grantmd/doorking-esp32/(commit log)

2026-04-11 Scaffold minimal ESP-IDF project for XIAO ESP32-C3
    First commit establishes a buildable ESP-IDF project targeting the Seeed
    XIAO ESP32-C3: top-level CMakeLists, sdkconfig.defaults (4 MB flash,
    two-OTA partition table, USB Serial/JTAG console, 1 kHz FreeRTOS tick),
    and a main component that logs chip info and heartbeats once per second.
    Confirmed building and flashing cleanly — this is our known-good starting
    point before adding gate state machine, NVS config, WiFi, and the HTTP
    API in subsequent commits.
2026-04-11 Add pure-C gate state machine with host-side tests
    gate_sm.{c,h} is a zero-dependency state machine that owns every gate
    transition rule: UNKNOWN → CLOSED/OPEN at boot, ACCEPTED/IDEMPOTENT/
    THROTTLED command results, OPENING→OPEN on status edge, OPENING→STOPPED
    on travel timeout, CLOSING→CLOSED on travel timeout (we have no closed
    sensor), CLOSING→OPEN when the DKS safety reverse re-asserts fully-open
    mid-close, and OPEN→CLOSING on an externally-triggered close (wired
    keypad, remote). Only the fully-open bit from the 4602-010 dry relay is
    available as ground truth; everything else is disambiguated via command
    history and a travel timer.
    test/test_gate_sm.c exercises 19 scenarios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
    [gate_sm.c, gate_sm.h, main.c]
2026-04-11 Add NVS config module with defaults-on-missing
    config.{c,h} wraps NVS access for the bridge's persistent settings: WiFi
    station credentials, HTTP bearer token, gate timings (pulse width, command
    throttle, travel timeout), and the mDNS hostname. config_load fills in
    compile-time defaults for any missing key so a blank device boots with
    sensible behaviour, and config_save writes the whole struct atomically in
    a single nvs_commit. Secrets (wifi_psk, auth_token) never appear in logs
    — config_log only reports whether they are set.
    main.c now initialises nvs_flash (erasing and retrying on
    NVS_NO_FREE_PAGES / NVS_NEW_VERSION_FOUND per the standard ESP-IDF
    pattern), loads config, logs it, and fee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
    [config.c, config.h, main.c]
2026-04-11 Add WiFi STA with AP-mode provisioning fallback
    wifi.{c,h} owns all WiFi bring-up and picks a mode at boot from the
    persisted config. If wifi_ssid is set we come up in STA mode with
    auto-reconnect on every WIFI_EVENT_STA_DISCONNECTED and modem power
    save disabled (latency over battery life for a wall-powered gate
    controller). Otherwise we come up in AP mode broadcasting an open
    "doorking-setup" SSID and start a tiny esp_http_server on port 80.
    The provisioning server serves two routes:
    GET / -> a ~1 KB HTML form with mobile-first CSS
    POST /provision -> parses application/x-www-form-urlencoded, writes
    ssid/psk to NVS, mints a fresh 64-hex-char bearer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
2026-04-11 Add README with status, build, and provisioning walkthrough
    Captures the current state of the project (scaffold + gate state machine
    + config + wifi provisioning done, HTTP API and hardware layer pending),
    documents the ESP-IDF toolchain install, covers build and flash from a
    fresh clone, and walks through the AP-mode provisioning flow end to end
    including the one-shot bearer token that only appears on the success
    page. Intended as a recoverable entry point for working on this repo
    after a break.
2026-04-11 Add factory reset via BOOT-button hold
    Press and hold the XIAO ESP32-C3 BOOT button (GPIO9) for 5 seconds
    while the firmware is running to clear wifi_ssid, wifi_psk, and
    auth_token from NVS and reboot into AP provisioning mode. Gate timings
    and hostname are preserved so the user only has to redo wifi.
    reset_btn_sm.{c,h} is a pure-C debounce + one-shot hold-threshold state
    machine with no ESP-IDF dependencies; 7 host-side tests in
    test/test_reset_btn_sm.c cover unpressed, under-threshold, at-threshold
    (fires exactly once), past-threshold single-sample fire, short-press
    re-arm, release-after-fire re-arm, and rapid press trains. The sm is
    consumed by a 50 ms polling FreeRTOS task in reset_butt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
    [config.c, config.h, main.c, reset_btn_sm.c, reset_btn_sm.h, reset_button.c, reset_button.h]
2026-04-11 Log bearer token to serial as a backup delivery channel
    When provisioning runs, the success HTML page is the primary channel
    for handing the user the newly-minted bearer token — but in practice
    iOS captive-portal views fail to render the page cleanly when the
    underlying AP is about to go away, so the user submits the form,
    sees a browser error, and the token is lost.
    Two backups:
    1. config_log now prints the full auth_token value at every boot.
    Threat-model comment inline: seeing it requires physical USB
    access, which is the same trust level as physical access to the
    gate controller itself. Tighten if needed later.
    2. handle_provision emits a WARN-level log with the freshly-min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
    [config.c, wifi.c]
2026-04-11 Stop httpd cleanly before provisioning reboot
    After submitting the provisioning form, the reboot task was yanking
    WiFi out from under any lingering httpd sockets (browser keepalives,
    favicon probes) during shutdown. Those sockets then hit EHOSTUNREACH
    on their next recv() and emit "httpd_sock_err: error in recv : 113"
    warnings. Harmless but noisy.
    Call httpd_stop before esp_restart so the provisioning server closes
    its listen socket and drains client sockets gracefully first. Also
    clear s_provision_httpd to NULL so the pointer is never dangling.
    [wifi.c]
2026-04-11 Add GitHub Actions workflow: host tests + firmware build + release on tag
    build.yml runs on every push to main, every PR to main, and every tag
    push matching v*. Always: run the host-side unit tests in test/, then
    invoke espressif/esp-idf-ci-action to build the ESP-IDF project for
    esp32c3 inside the official IDF v5.3 Docker image, and merge the
    partition binaries into a single doorking-merged.bin that can be
    flashed to 0x0 in one shot. All artifacts (individual partitions,
    merged image, elf) are uploaded as a workflow artifact for easy pickup
    from any run.
    On tag push (v*), additionally publish a GitHub Release via
    softprops/action-gh-release with the five binaries attached and
    auto-generat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
2026-04-11 Bump GitHub Actions to current majors
    actions/checkout v4 → v6 and actions/upload-artifact v4 → v7. v4 of
    both runs on node20 which is generating deprecation warnings on GH's
    hosted runners; the newer majors run on node24 and clear the warnings.
    Using floating major tags so future non-breaking patch releases land
    automatically. softprops/action-gh-release and
    espressif/esp-idf-ci-action are already on their current majors.
2026-04-11 Bump ESP-IDF to v5.5 in CI
    Verified locally that the entire existing firmware (gate_sm, config,
    wifi, reset_button, provisioning httpd, all 1008 build steps) builds
    clean on ESP-IDF v5.5.4-299 for esp32c3 with zero code changes, zero
    deprecation warnings, and zero API churn. Binary grows from 0xc9320
    bytes (v5.3) to 0xcd070 bytes (v5.5) — a ~16 KB increase from updated
    component libraries, still leaving 20% free in the 1 MB app partition.
    v5.5 is the first ESP-IDF release with stable ESP32-C5 support, which
    unblocks the upcoming multi-target refactor. The workflow pin moves
    from v5.3 to v5.5; other actions stay as-is.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
2026-04-11 Refactor to multi-target layout: split sdkconfig.defaults + board.h
    Pure refactor, no behavior change on esp32c3. Introduces the scaffolding
    required to add esp32 (SparkFun Thing Plus WROOM) and esp32c5 (SparkFun
    Thing Plus C5) targets in subsequent commits.
    sdkconfig.defaults now holds only settings shared across every
    supported target: the two-OTA partition layout, the 1 kHz FreeRTOS
    tick, the compiler warning flags, and the esp_http_server header/URI
    buffer sizes. CONFIG_IDF_TARGET is no longer pinned there; it is now
    chosen at configure time by idf.py set-target, and ESP-IDF merges the
    matching sdkconfig.defaults.<target> automatically on top of the
    common defaults.
    sdkconfig.defaults.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
    [board.h, main.c, reset_button.c]
2026-04-11 Rewrite README for multi-target framing
    Drops the C3-only assumptions that survived from the initial scaffold
    and reframes the project as a multi-target firmware that happens to be
    verified on C3 today. New "Supported targets" table lists the C3 as
    done, WROOM and C5 as planned. Hardware section standardises on the
    Qwiic / I2C Single Relay topology across all three targets (two
    SparkFun Qwiic Single Relays at 0x18 and 0x19, daisy-chained) instead
    of the previous HW-383 GPIO relay module.
    Wiring-to-DKS table now expresses signals in target-independent terms
    (relay I2C address + pin numbers) rather than in terms of specific
    ESP32-C3 GPIOs, so the same table works for every supported board.
    I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
2026-04-11 Add esp32 (SparkFun Thing Plus WROOM) target
    sdkconfig.defaults.esp32 pins the 16 MB flash size, notes that the
    common CONFIG_PARTITION_TABLE_TWO_OTA layout only uses the first ~3 MB
    (we can revisit if the binary ever grows past 1 MB), and documents why
    no console routing override is needed (UART0 is the ESP32 default and
    the board's onboard CH340C USB-UART bridge exposes it over USB-C).
    main/board.h gains a #elif CONFIG_IDF_TARGET_ESP32 block defining
    BOARD_NAME and RESET_BUTTON_GPIO=0 for the Thing Plus. GPIO0 is the
    BOOT button on every ESP32 Feather/Thing Plus and, like GPIO9 on the
    C3, is a strapping pin — so the runtime-press-only caveat still
    applies.
    GOTCHA specific to this board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
2026-04-11 CI: matrix-build esp32c3 + esp32, split release into its own job
    Convert the single-target build job into a strategy.matrix.include with
    per-target flash_size, flash_freq, and bootloader_offset. The XIAO
    ESP32-C3 uses a 4 MB / 80 MHz / 0x0-bootloader layout; the SparkFun
    Thing Plus WROOM uses 16 MB / 40 MHz / 0x1000-bootloader. fail-fast is
    off so one target breaking doesn't hide the state of the other.
    Artifacts upload per-target as firmware-<target> (each matrix cell runs
    upload-artifact independently). The merged binary produced by esptool
    merge_bin is now renamed to doorking-<target>-merged.bin so both
    targets' outputs can coexist in a single release without filename
    collision.
    The rel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
2026-04-11 Add esp32c5 (SparkFun Thing Plus ESP32-C5) target
    Third supported target, joining esp32c3 (XIAO) and esp32 (Thing Plus
    WROOM). Adds sdkconfig.defaults.esp32c5 with the 8 MB flash size and
    the ESP32-C5's native USB Serial/JTAG console routing, a board.h
    block for the SparkFun Thing Plus C5 with BOARD_NAME and
    RESET_BUTTON_GPIO=28 (the C5's boot-mode strapping pin — different
    from C3's GPIO9 and ESP32's GPIO0), and a third CI matrix cell so
    every push builds the C5 binary alongside the other two.
    Pin for BOOT button confirmed from the SparkFun Thing Plus C5
    datasheet PDF (~/SparkFun_Thing_Plus_ESP32_C5.pdf via sparkfun.com
    CDN), not guessed from strapping-pin conventions. Worth noting becau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
2026-04-11 Switch default build to -Os and disable 802.15.4 on C5
    Flipping CONFIG_COMPILER_OPTIMIZATION_SIZE=y in the common
    sdkconfig.defaults moves every target from -Og (debuggable) to -Os
    (size-optimised), which saves a meaningful chunk of app-partition
    runway. Assertions stay on; debug symbols still fine for serial-log
    debugging; the only real cost is slightly harder step-through via
    JTAG, which we're not doing anyway.
    Also sets CONFIG_IEEE802154_ENABLED=n in sdkconfig.defaults.esp32c5
    so the Thread/Zigbee radio driver path is explicitly opted out on the
    C5. Savings are modest (~8 KB, most of the 802.15.4 code lives in a
    precompiled blob the linker can't strip) but the Kconfig setting
    records the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
2026-04-12 Add scripts/idf.sh wrapper for sandbox-friendly build invocations
    Running idf.py requires sourcing ESP-IDF's export.sh first, and the
    canonical ". ~/esp/esp-idf-v5.5/export.sh && idf.py build" pattern
    has the POSIX source operator as its first command token. That's an
    unbounded command prefix from a sandbox / agent whitelist standpoint
    — permitting it effectively permits sourcing anything on disk — so
    it's reasonable to refuse to whitelist. Without a whitelist, every
    build invocation from an agent hits manual approval, which kills the
    feedback loop on this multi-target project where we're running
    per-target builds all day.
    scripts/idf.sh is a thin wrapper that sources $HOME/esp/esp-idf-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
2026-04-12 Switch to TWO_OTA_LARGE partition layout + idf.py merge-bin in CI
    CONFIG_PARTITION_TABLE_TWO_OTA_LARGE replaces TWO_OTA in the common
    sdkconfig.defaults, growing the OTA app slots from 1 MB to 1700 KB
    each. There is no factory slot in this layout — OTA still works
    exactly the same way (ping-pongs between ota_0 and ota_1, supports
    rollback) because the factory slot is only relevant for commercial
    products where an unrecoverable brick is a business problem. For a
    developer-owned gate controller where USB re-flash is a 10-second
    operation, the factory slot is zero-value storage and swapping it
    for 1.4 MB of additional app headroom is a clean win.
    Verified locally on all three targets after a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
2026-04-12 README: update status, partition sizes, install paths, repo layout
    Align the README with the current reality of the repo:
    * Status table now records that esp32c3 and esp32 are both
    build-verified AND hardware-verified on real boards (XIAO
    ESP32-C3, SparkFun Thing Plus WROOM), while esp32c5 is
    build-verified only. Adds rows for the per-target board.h pin
    map (all three filled), size-optimised -Os build with
    TWO_OTA_LARGE 1700 KB slots, the scripts/idf.sh wrapper, and the
    3-target matrix CI.
    * Binary size table shows current figures under the new
    partition layout: esp32c3 744 KB / 56 % free, esp32 724 KB / 57 %
    free, esp32c5 825 KB / 51 % free. This replaces the older
    "only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
2026-04-12 Add RAM log ring buffer, HTTP API skeleton, GET /health and GET /logs
    Three new modules land in one commit because they're tightly coupled:
    log_buffer.{c,h}
    16 KB circular byte buffer protected by a FreeRTOS mutex. Installed
    via esp_log_set_vprintf FIRST in app_main — before NVS, WiFi, or
    any other module logs anything — so boot-time output is captured.
    The hook tees every formatted log line to both the ring buffer and
    stdout (via fputs) so the serial monitor continues to work when USB
    is attached. log_buffer_snapshot returns a malloc'd chronological
    copy of the current contents for consumption by the HTTP handler.
    http_api.{c,h}
    Main STA-mode HTTP server (separate from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
    [http_api.c, http_api.h, log_buffer.c, log_buffer.h, main.c]
2026-04-12 Add GET /status, POST /open, POST /close gate-control endpoints
    Three new bearer-authed endpoints in http_api.c, all wired to the
    same gate_sm instance that the tick loop drives:
    GET /status — returns {"state":"UNKNOWN","last_cmd":"none",
    "last_cmd_age_s":0} with the current gate state,
    the most recent accepted command, and seconds since
    that command was issued. Homebridge's HTTP garage-
    door plugin polls this to update HomeKit state.
    POST /open — calls gate_sm_on_cmd_open. Returns {"result":
    "accepted"} and transitions the state machine to
    OPENING, or {"result":"idempotent"} if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
    [gate_sm.c, gate_sm.h, http_api.c, http_api.h, main.c]
2026-04-12 Add mDNS so the device advertises as <hostname>.local
    In STA mode the firmware now calls mdns_init, sets the hostname from
    config (default "doorking"), and advertises an _http._tcp service on
    port 80. This lets the user (and Homebridge) reach the device at
    doorking.local without needing to discover its DHCP-assigned IP from
    the serial monitor or the router's client list.
    The mdns component was removed from the ESP-IDF source tree in v5.5
    and moved to the IDF Component Registry. main/idf_component.yml
    declares the dependency on espressif/mdns, which the component
    manager downloads into managed_components/ at build time (already
    gitignored).
    mDNS init is guarded by config_has_wifi so it only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
2026-04-12 Add I²C master bus init + boot-time device scan
    i2c_bus.{c,h} initialises the I²C master on the board-specific
    SDA/SCL pins (from board.h) at 100 kHz standard mode with internal
    pull-ups, then probes every 7-bit address from 0x01 to 0x77 and logs
    each responding device at INFO level. Known addresses are labelled
    inline:
    0x18 → SparkFun Qwiic Relay (default address)
    0x19 → SparkFun Qwiic Relay (alt address)
    0x36 → MAX17048 battery fuel gauge (onboard on the Thing Plus)
    The scan runs once at boot for diagnostics — "did the Qwiic cable
    come loose?" is a common field-debugging question — and returns the
    i2c_master_bus_handle_t for the future relay_i2c driver to register
    devic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
    [board.h, i2c_bus.c, i2c_bus.h, main.c]
2026-04-12 README: update status table and repo layout for latest modules
    Status table now reflects the HTTP API (/health, /logs, /status, /open,
    /close), the 16 KB RAM log ring buffer, mDNS, and the I²C bus init +
    boot-time device scan — all of which landed since the last README pass.
    Qwiic Relay I²C driver row clarifies that relay pulse stubs exist in
    the /open and /close handlers and are waiting on hardware. Binary sizes
    updated to current measurements including all new modules.
    Repo layout tree adds http_api, log_buffer, i2c_bus, and
    idf_component.yml (IDF Component Registry manifest for mdns).
2026-04-12 Add WS2812 status LED driven by WiFi state
    status_led.{c,h} maps high-level WiFi states to solid colours on the
    onboard WS2812 (NeoPixel) RGB LED:
    blue — AP provisioning mode, waiting for WiFi setup
    yellow — STA mode, connecting to WiFi
    green — STA mode, connected and ready
    red — STA mode, WiFi lost (auto-reconnecting)
    Brightness is capped at 24/255 so the LED is visible but not blinding
    inside a dark gate-operator enclosure.
    On the XIAO ESP32-C3 (no user-controllable LED), all status_led
    functions compile as empty no-ops — guarded by #ifdef STATUS_LED_GPIO
    in board.h. The WS2812 GPIO pin is board-specific:
    esp32 (Thing Plus WROOM): GPIO2
    esp32c5 (Thing Pl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
2026-04-12 Add OTA update support with push, pull, and dashboard
    Two update paths: push (POST /update with a binary) for development,
    and pull (periodic GitHub Releases check) for in-field updates. The
    device checks every 6 hours by default (configurable via NVS) and
    caches the available version for the dashboard and /health endpoint.
    Key pieces:
    - Version embedded via git describe → PROJECT_VER → esp_app_desc_t
    - Rollback protection: CONFIG_BOOTLOADER_APP_ROLLBACK_ENABLE with a
    120 s WiFi watchdog; bad firmware self-heals on next reboot
    - GET / serves a lightweight dashboard showing version, target, GitHub
    link, and an "Update firmware" button when an update is available
    - GET /health now ret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
    [config.c, config.h, http_api.c, http_api.h, main.c, ota.c, ota.h, status_led.c]
2026-04-13 Add POST /reboot endpoint for remote device restart
    Bearer-authenticated endpoint that sends a JSON response then restarts
    the device after a 1-second delay. Useful for triggering an OTA check
    cycle or general remote management without physical access.
    [http_api.c, http_api.h]
2026-04-13 Fix pull OTA: manually follow HTTP 302 redirects from GitHub CDN
    esp_http_client_open + manual read loop doesn't auto-follow redirects
    (that's only done by esp_http_client_perform, which buffers the entire
    response). GitHub's asset download URLs always 302 to their CDN, so
    the download was failing with "unexpected HTTP status 302".
    Fix: loop up to 5 times, reading the Location header on 3xx responses
    and re-opening the connection to the redirect target.
    [ota.c]
2026-04-13 Add dashboard check/reboot buttons, POST /update/check, update README
    Dashboard now has "Check for updates" (triggers a GitHub check, reloads
    after 5s) and "Reboot" buttons alongside the existing update button.
    All three prompt for the bearer token on first use and cache it for the
    session.
    New endpoint POST /update/check runs a check-only GitHub query (no
    install) and updates the cached available version.
    README updated to reflect OTA support, new endpoints, binary sizes,
    repo layout, and added an OTA section documenting both update paths,
    the dashboard, and rollback behaviour.
    [http_api.c, http_api.h, ota.c, ota.h]
2026-04-13 Fix pull OTA redirect: use esp_http_client_set_redirection
    esp_http_client_get_header looks up request headers, not response
    headers — so the Location header was never found. The client already
    parses Location internally; esp_http_client_set_redirection() is the
    correct API to apply it to the next request.
    [ota.c]
2026-04-13 Fix pull OTA: bump TX buffer for long CDN redirect URLs
    GitHub's CDN redirect URLs (objects.githubusercontent.com/...) are
    longer than the default 512-byte TX buffer, causing "Out of buffer"
    on the second request after the 302 redirect. Bump to 1024.
    [ota.c]
2026-04-14 Reduce heap pressure during OTA checks, silence mDNS log noise
    Shrink mbedTLS TLS input buffer from 16 KB to 4 KB and cap the GitHub
    release JSON buffer at 8 KB. This frees ~20 KB of peak heap during OTA
    checks but doesn't fully eliminate mDNS allocation failures on the
    ESP32 WROOM (320 KB DRAM).
    Suppress the remaining transient mDNS errors (mdns_send, mdns_receive,
    mdns_networking) via esp_log_level_set — they're harmless (mDNS recovers
    when TLS closes) but were filling the 16 KB log ring buffer with noise.
    [main.c, ota.c]
2026-04-14 Add OpenSCAD mounting baseplates for all three board variants
    Two baseplate designs holding a dev board + two Qwiic Single Relay
    modules: one for the SparkFun Thing Plus (WROOM or C5) using standoffs,
    and one for the Seeed XIAO ESP32-C3 using a friction-fit clip holder.
    Board dimensions sourced from SparkFun Eagle/KiCad design files and
    Seeed Studio documentation. Shared parameters and modules live in
    baseplate-common.scad.
    [baseplate-common.scad, baseplate-thingplus.scad, baseplate-xiao.scad]
2026-04-14 Flip Thing Plus orientation and add support posts at radio end
    Orient the Thing Plus with USB-C facing away from the relays for cable
    access. Add solid support posts (no screw holes) at the radio end to
    prevent board flex.
    [baseplate-common.scad, baseplate-thingplus.scad]
2026-04-14 README: add enclosure section, update status table and repo layout
    Document the OpenSCAD baseplates, add missing status entries for the
    LED, /update/check, and /reboot, and include enclosure/ in the repo
    layout tree.
2026-04-18 Add /i2c/scan and /i2c/relay-address diagnostic endpoints
    Re-uses the existing boot-time I²C bus handle to expose two bearer-authed
    HTTP endpoints: /i2c/scan returns every ACK'd address with a label for
    known devices, and /i2c/relay-address writes the SparkFun Qwiic Single
    Relay SINGLE_CHANGE_ADDRESS command (register 0x03) to reassign a
    relay's I²C address without needing Arduino or extra wiring. Used to
    move one of two relays off the default 0x18 so both can share the bus.
2026-04-19 Add Qwiic Single Relay driver, wire to /open and /close
    relay_i2c attaches device handles for the OPEN and CLOSE relays on the
    shared I²C bus and exposes pulse_open / pulse_close, each of which
    writes 0x01 (ON) → delay pulse_ms → writes 0x00 (OFF). The HTTP
    handlers call these on GATE_CMD_RESULT_ACCEPTED, returning 500 with the
    esp_err_t name on transmit failure.
    Relay I²C addresses are NVS-backed (relay_open_addr=0x18,
    relay_close_addr=0x19 by default), matching the convention from the
    /i2c/relay-address endpoint. A missing relay at boot is non-fatal; the
    pulse calls surface the timeout when hit.
    [config.c, config.h, http_api.c, main.c, relay_i2c.c, relay_i2c.h]
2026-04-19 README: reflect relay driver + /i2c endpoints, mark C5 Qwiic I²C deferred
    Relay driver shipped; /open and /close pulse the Qwiic relays on the
    WROOM end-to-end. Document the runtime address-reassignment flow via
    POST /i2c/relay-address since the Qwiic Single Relay has no physical
    jumper. C5 Qwiic pins (GPIO6/7) require LP_I²C support which the
    current driver doesn't implement — tracked as a post-v1.0.0 follow-up.
2026-04-19 Add 4602-010 "fully open" status GPIO input
    status_input polls a per-target GPIO (XIAO=GPIO4, WROOM=GPIO13,
    C5=GPIO10) every 50 ms with a 150 ms debounce window, seeds the gate
    state machine with the initial reading at boot, and feeds every stable
    edge into gate_sm_on_status_change. With the pin actually wired to the
    DKS dry relay (pin 15-16 set to "fully open" via SW1 switches 4=OFF
    5=OFF), OPENING transitions to OPEN on the physical contact close
    instead of waiting for the 30 s travel timeout, and human-driven gate
    movements (keypad, Chamberlain remote) also update state live.
    Floating the pin leaves the existing 30 s travel-timer behavior intact
    — the pin reads HIGH via internal pull-u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
2026-04-19 README: warn to check DKS pins 15-16 before flipping SW1-4/5
    SW1-4 and SW1-5 only retarget the configurable dry relay, but if an
    existing warning light / buzzer / monitoring wire is already landed on
    pins 15-16, it will behave differently after the switch change. Empty
    terminals are a no-op.
2026-04-20 Move WROOM STATUS_INPUT_GPIO off GPIO13 (STAT LED) to GPIO27
    GPIO13 on the SparkFun Thing Plus ESP32 WROOM is wired to an onboard
    blue STAT LED through a hard pull-down resistor. That pull-down fights
    our internal pull-up and produces ambiguous / false-LOW readings on
    the gate-status input, breaking the sensor path. GPIO27 is a clean
    bidirectional pin with no onboard peripheral or strapping role — use
    that instead.
    Caught before wiring anything to the gate, so no field impact.
2026-04-21 Surface OTA progress + failures in the dashboard UI
    Previously, clicking "Update firmware" left the page showing
    "Downloading and flashing…" regardless of outcome — if the GitHub/CDN
    download died partway through (MBEDTLS_ERR_SSL_UNEXPECTED_MESSAGE is
    the transient symptom we see in practice), the only signal was the
    serial log. Users who don't tail logs had no idea an update failed.
    New pieces:
    * ota_state_t: IDLE | CHECKING | DOWNLOADING | FAILED, plus a
    last-error string. Every failure path in ota.c's push, check, and
    pull flows calls ota_fail() with a short human-readable message;
    the existing ESP_LOGE entries are preserved for serial diagnostics.
    * GET /update/status — un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
    [http_api.c, http_api.h, ota.c, ota.h]
2026-04-21 README: document /update/status + dashboard progress polling
    Covers the new unauthenticated GET /update/status endpoint, the
    rewritten dashboard flow that polls it during checks and updates, and
    the fact that "Check for updates" no longer requires a token.
2026-04-21 Add silent /favicon.ico handler
    Every dashboard page view logged a 404 for /favicon.ico as browsers
    auto-requested it. Respond with a 204 No Content instead — cheaper
    than a real favicon and removes the log noise entirely.
    [http_api.c]
